mattbrejza/particle-detector/generator-board/generator.brd

## EAGLE design generator-board/generator.brd (2016-04-07)

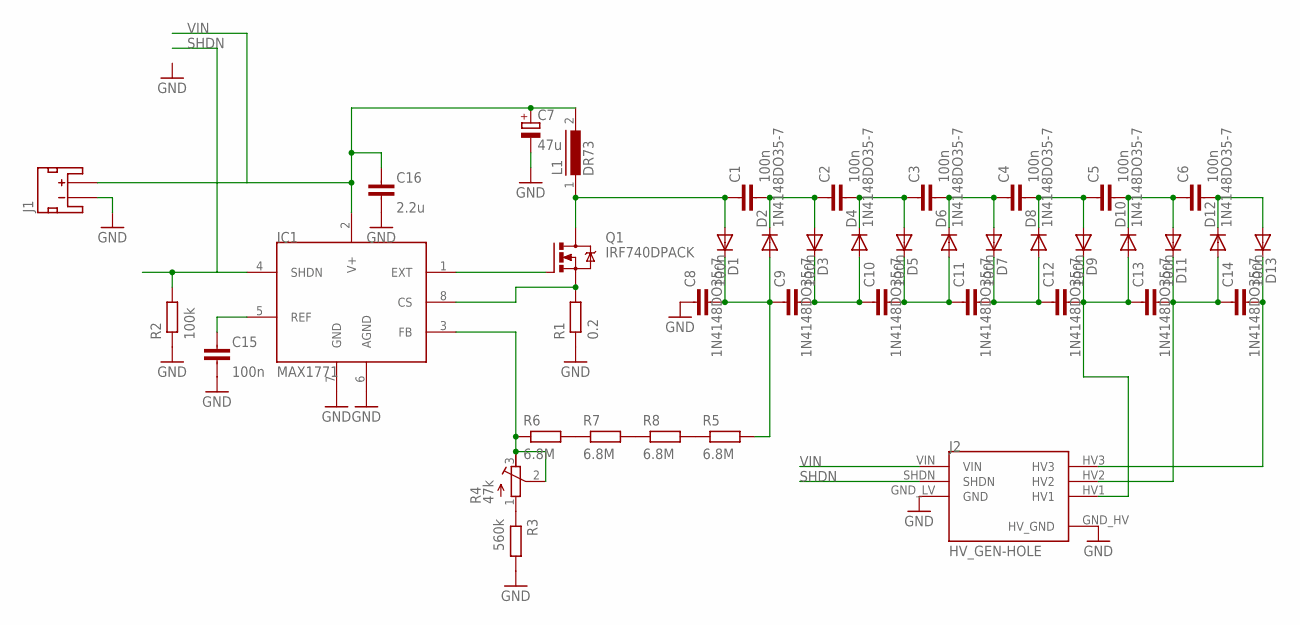
[picture p1: schematic generator.sch]

Parts:
C1, C2, C3, C4, C5, C6, C8, C9, C10, C11, C12, C13, C14: 100n; C1206-N; FARNELL 1855877
C7: 47u; E2-5; VOLTAGE 16V; FARNELL 9452460
C15: 100n; C0603-N; FARNELL 2495332
C16: 2.2u; C0603-N; FARNELL 2496923
D1, D2, D3, D4, D5, D6, D7, D8, D9, D10, D11, D12, D13: 1N4148DO35-7; DO35-7; FARNELL 1625213
IC1: MAX1771; SO08
J1: JST_2MM_MALE_TH; JST-2-TH
J2: HV_GEN-HOLE; BRD-LAYOUT2
L1: DR73; FARNELL 2061654
Q1: IRF740DPACK; DPACK_1; FARNELL 2453433
R1: 0.2; R0805-N; FARNELL 2328089
R2: 100k; R0603-N
R3: 560k; R0603-N
R4: 47k; RTRIM3103; FARNELL 1771727
R5, R6, R7, R8: 6.8M; R0603-N; FARNELL 2138708

Connections:
GND: C7.-, C8.1, C15.2, C16.2, IC1.6 (AGND), IC1.7 (GND), J1.2 (-), J2.GND_HV (HV_GND), J2.GND_LV (GND), R1.1, R2.1, R3.2
unnamed: IC1.8 (CS), Q1.E (S), R1.2
unnamed: IC1.1 (EXT), Q1.B (G)
unnamed: C8.2, C9.1, D1.C, D2.A, R5.2
unnamed: C15.1, IC1.5 (REF)
unnamed: C1.1, D1.A, L1.1, Q1.C (D)
unnamed: C1.2, C2.1, D2.C, D3.A
unnamed: C9.2, C10.1, D3.C, D4.A
unnamed: C2.2, C3.1, D4.C, D5.A
unnamed: C10.2, C11.1, D5.C, D6.A
unnamed: C3.2, C4.1, D6.C, D7.A
unnamed: C11.2, C12.1, D7.C, D8.A
unnamed: C4.2, C5.1, D8.C, D9.A
unnamed: C12.2, C13.1, D9.C, D10.A, J2.HV1
unnamed: C5.2, C6.1, D10.C, D11.A
unnamed: C13.2, C14.1, D11.C, D12.A, J2.HV2
unnamed: IC1.3 (FB), R4.2 (S), R4.3 (E), R6.1
unnamed: R5.1, R8.2
unnamed: R7.2, R8.1
unnamed: R6.2, R7.1
unnamed: R3.1, R4.1 (A)
unnamed: C6.2, D12.C, D13.A
unnamed: C14.2, D13.C, J2.HV3
SHDN: IC1.4 (SHDN), J2.SHDN, R2.2
VIN: C7.+, C16.1, IC1.2 (V+), J1.1 (+), J2.VIN, L1.2

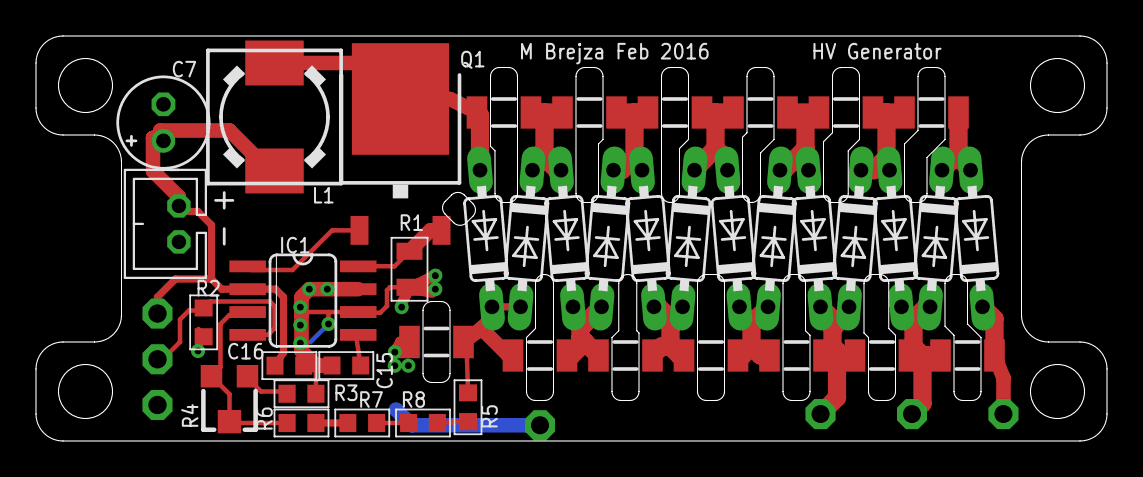
[picture p2: board generator.brd from above]

Board: 2 copper layers, 59.5 x 22.5 mm, 42 parts (0 on the bottom side), 25 nets.
