mattbrejza/particle-detector/gm-board/gm-board.brd

## EAGLE design gm-board/gm-board.brd (2016-02-13)

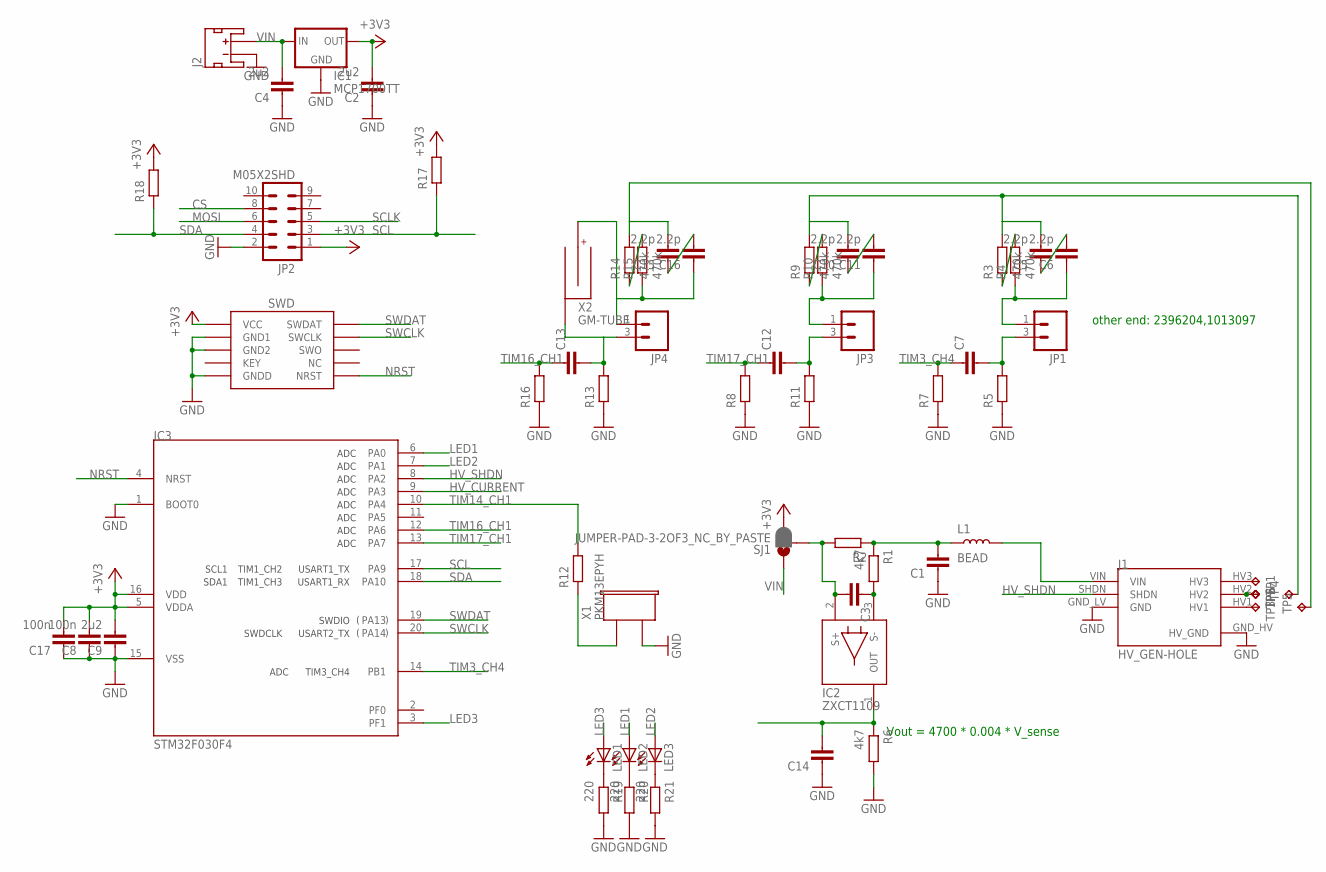
[picture p3: schematic gm-board.sch]

Parts:
C1, C3, C7, C12, C13, C14: CAPACITOR0603-N; C0603-N
C2, C4, C9: 2u2; C0603-N; FARNELL 2496923
C5, C6, C10, C11, C15, C16: 2.2p; C0805-N; FARNELL 1855767
C8, C17: 100n; C0603-N
IC1: MCP1700TT; SOT23
IC2: ZXCT1109; SOT23; FARNELL 1904028
IC3: STM32F030F4; TSSOP20; FARNELL 2393635
J1: HV_GEN-HOLE; BRD-LAYOUT2
J2: JST_2MM_MALE_TH-NT; JST-2-TH-NOTEXT
J3: SWD_SHROUD; SWD_PTH_SHROUD
JP1, JP3, JP4: M02-HV; M03-HV; FARNELL 1462950
JP2: M05X2SHD; 2X5-SHROUDED
L1: BEAD; L0603-N; FARNELL 1781093
LED1, LED2, LED3: LEDCHIPLED_0603; CHIPLED_0603
R1, R6: 4k7; R0603-N
R2: RESISTOR0603-N; R0603-N; FARNELL 2328089
R3, R4, R9, R10, R14: 470k; R1206-N; FARNELL 1576201
R5, R7, R8, R11, R12, R13, R16, R17, R18: RESISTOR0603-N; R0603-N
R15: 470k; R1206-N
R19, R20, R21: 220; R0603-N
SJ1: JUMPER-PAD-3-2OF3_NC_BY_PASTE; PAD-JUMPER-3-2OF3_NC_BY_PASTE_YES_SILK_FULL_BOX
TP1, TP2, TP3, TP4, TP5, TP6: TPTP09R; TP09R
X1: PKM13EPYH
X2: GM-TUBE

Connections:
+3V3: C2.2, C8.2, C9.2, C17.2, IC1.2 (OUT), IC3.5 (VDDA), IC3.16 (VDD), J3.1 (VCC), JP2.1, R17.2, R18.2, SJ1.3
CS: JP2.8
GND: C1.1, C2.1, C4.1, C8.1, C9.1, C14.1, C17.1, IC1.1 (GND), IC3.1 (BOOT0), IC3.15 (VSS), J1.GND_HV (HV_GND), J1.GND_LV (GND), J2.2 (-), J3.3 (GND1), J3.5 (GND2), J3.9 (GNDD), JP2.2, R5.1, R6.2, R7.1, R8.1, R11.1, R13.1, R16.1, R19.2, R20.2, R21.2, X1.2
HV_CURRENT: C14.2, IC2.1 (OUT), IC3.9 (PA3), R6.1
HV_SHDN: IC3.8 (PA2), J1.SHDN
LED1: IC3.6 (PA0), LED2.A
LED2: IC3.7 (PA1), LED3.A
LED3: IC3.3 (PF1), LED1.A
MOSI: JP2.6
unnamed: C13.2, JP4.3 (2), R13.2, X2.B1 (-), X2.B2 (-)
unnamed: J1.VIN, L1.2
unnamed: C16.1, JP4.1, R15.1, X2.A1 (+), X2.A2 (+)
unnamed: R14.1, R15.2
unnamed: C12.2, JP3.3 (2), R11.2
unnamed: R12.1, X1.1
unnamed: C1.2, L1.1, R1.1, R2.1
unnamed: C15.2, R14.2, TP5.TP
unnamed: C7.2, JP1.3 (2), R5.2
unnamed: J1.HV3, TP1.TP
unnamed: C3.2, IC2.2 (S+), R2.2, SJ1.2
unnamed: J1.HV2, TP2.TP, TP6.TP
unnamed: J1.HV1, TP3.TP
unnamed: LED1.C, R19.1
unnamed: LED2.C, R20.1
unnamed: C15.1, C16.2
unnamed: LED3.C, R21.1
unnamed: C3.1, IC2.3 (S-), R1.2
unnamed: C11.1, JP3.1, R10.1
unnamed: C5.2, C10.2, R3.2, R9.2, TP4.TP
unnamed: R9.1, R10.2
unnamed: C10.1, C11.2
unnamed: C6.1, JP1.1, R4.1
unnamed: R3.1, R4.2
unnamed: C5.1, C6.2
NRST: IC3.4 (NRST), J3.10 (NRST)
SCL: IC3.17 (PA9), JP2.3, R17.1
SCLK: JP2.5
SDA: IC3.18 (PA10), JP2.4, R18.1
SWCLK: IC3.20 (PA14), J3.4 (SWCLK)
SWDAT: IC3.19 (PA13), J3.2 (SWDAT)
TIM3_CH4: C7.1, IC3.14 (PB1), R7.2
TIM14_CH1: IC3.10 (PA4), R12.2
TIM16_CH1: C13.1, IC3.12 (PA6), R16.2
TIM17_CH1: C12.1, IC3.13 (PA7), R8.2
VIN: C4.2, IC1.3 (IN), J2.1 (+), SJ1.1

Notes on the sheet:
Vout = 4700 * 0.004 * V_sense
other end: 2396204,1013097

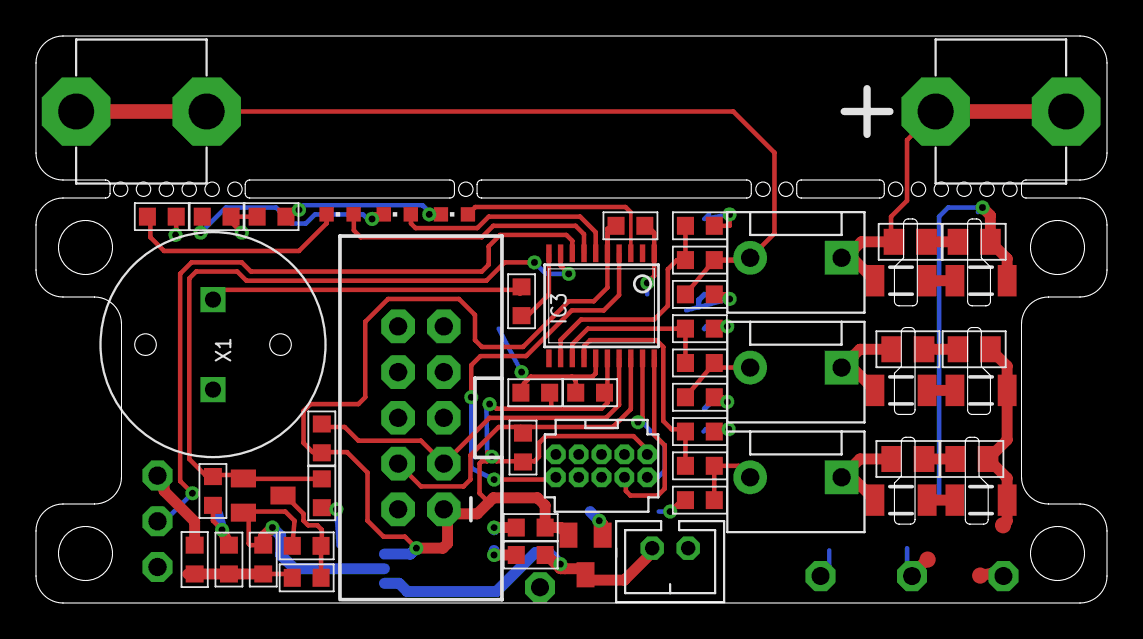
[picture p4: board gm-board.brd from above]

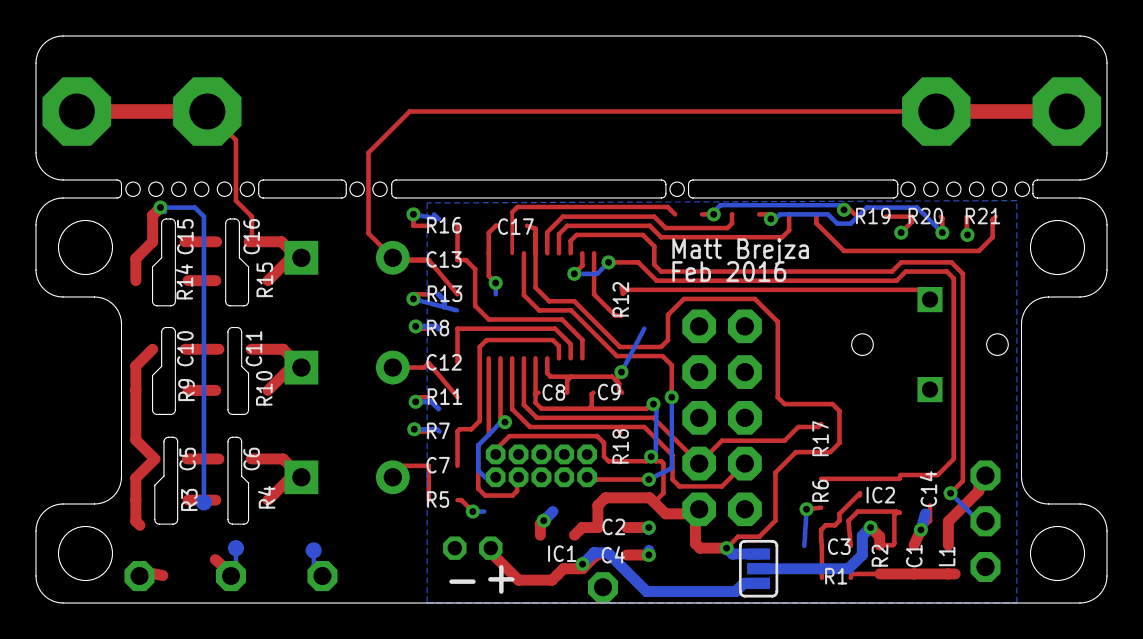
[picture p5: board gm-board.brd from below]

Board: 2 copper layers, 59.5 x 31.5 mm, 61 parts (4 on the bottom side), 42 nets.
