mattbrejza/particle-detector/(commit log)

2015-11-30 adding high voltage generator
    [generator.brd, generator.sch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]
2016-01-27 adding testpad, starting counting board
    [generator.brd, generator.sch, gm-board.sch]
2016-02-04 done gen bom, almost done coutner
    [generator.brd, generator.sch, gm-board.brd, gm-board.sch]
2016-02-05 adding part ordering numbers
    [generator.brd, generator.sch, gm-board.brd, gm-board.sch]
2016-02-06 almost done
    [generator.brd, generator.sch, gm-board.brd, gm-board.sch]
2016-02-08 gettuing there...
    [gm-board.brd, gm-board.sch]
2016-02-12 now to panelize
    [generator.brd, gm-board.brd, gm-board.sch]
2016-02-13 about to panelize
    [generator.brd, generator.sch, gm-board.brd, gm-board.sch]
2016-04-07 final board, started firmware
    [generator.brd, generator.sch]
2016-04-11 adding spi comms
2016-04-30 mostly working (still adc to fix)
    [main.c]
